lo2545/Harnet/docs/technicalTask.md

# Техническое задание

## Проект: робот-паук «Harnet» на базе ESP32

---

## 1. Общие сведения

### 1.1 Цель проекта

Целью проекта является модернизация существующего робота-паука «Аркадий».
в текущей версии реализованного на платформе Arduino с управлением через
текстовые команды по Serial-интерфейсу (репозиторий `arkadiy-core`).
Репозиторий: https://github.com/VxDxK/arkadiy-core

В рамках проекта планируется:

1. **Перенос платформы** — перевод прошивки с Arduino на ESP32 (замена
   аппаратной базы и адаптация кода: библиотека сервоприводов, распиновка,
   питание).
2. **Интерфейс ввода команд** — замена текстового ввода через Serial-порт
   на более удобный способ управления (Wi-Fi веб-интерфейс)
3. **Автономность** — добавление режима, в котором робот самостоятельно
   выполняет задачу без команд оператора (см. раздел 2.1.6).
4. **Улучшение моторики и «живое» поведение** — доработка алгоритмов
   походки для более плавных и естественных движений, а также режим,
   в котором робот имитирует поведение живого паука при выполнении
   команд (см. разделы 2.1.3 и 2.1.4).

### 1.2 Команда исполнителей
 
| Участник | Роль |
|---|---|
| Шмидько Елизавета | Исполнитель проекта (разработка аппаратной части и ПО) |
 
---

## 2. Технические требования
 
### 2.1 Требования к функциональным характеристикам
 
#### 2.1.1 Перенос платформы (Arduino → ESP32)
 
- FR-1. Управляющая прошивка должна быть перенесена с платформы Arduino на
  ESP32 с сохранением текущего набора функций управления 12 сервоприводами.
- FR-2. Итоговый набор команд управления определяется новым интерфейсом
  ввода (см. 2.1.2) и не обязан совпадать с исходным текстовым набором
  (`sp`, `su`, `ruka`, `go`, `def`) из версии на Arduino.
#### 2.1.2 Интерфейс ввода команд
 
- FR-3. Управление роботом осуществляется через веб-интерфейс: ESP32
  запускает встроенный веб-сервер, страница управления открывается в
  обычном браузере без установки отдельных
  приложений.
- FR-4. Связь между устройством оператора и роботом — по Wi-Fi. ESP32
  работает в режиме собственной точки доступа: оператор
  подключается к сети робота напрямую, наличие внешнего роутера или
  интернета не требуется.
- FR-5. Веб-страница должна содержать органы управления для всех команд
  робота: движение, смена поз, включение и отключение «живого» и автономного
  режимов (см. 2.1.3, 2.1.6), а также составление и запуск серии команд.
- FR-6. Веб-страница должна отображать текущее состояние робота (активный
  режим, текущая поза/действие, наличие связи).
- FR-7. Страница должна корректно отображаться и быть удобной для
  управления на экране смартфона.

#### 2.1.3 Режимы работы и «живое» поведение

Робот работает в следующих режимах:

- **Командный режим (по умолчанию)** — оператор подаёт одиночные команды
  или серии команд, робот выполняет их без самостоятельного поведения
  между ними.
- **«Живой» режим** — включается и выключается отдельной командой и не
  заменяет командный режим, а дополняет его: оператор по-прежнему даёт
  одиночные команды и серии команд, но робот выполняет их и ведёт себя
  в паузах как живой паук.
- **Автономный режим** — робот сам выполняет задачу без команд оператора
  (см. 2.1.6).

Свойства «живого» режима:

- FR-8. **Фоновое «дыхание»** — в состоянии покоя (в том числе между
  командами) корпус и/или ноги робота совершают едва заметные, ритмичные
  микродвижения, имитирующие дыхание живого существа.
- FR-9. **Реакция на внешние раздражители (желательная функция, не
  обязательна для приёмки)** — при обнаружении прикосновения, звука или
  приближения объекта (по данным эхолокаторов) робот выполняет одну из
  защитных реакций: резкое отдёргивание ближайшей ноги либо
  кратковременное «замирание» (полная остановка всех движений).
- FR-10. **Живое выполнение команд** — перед началом движения по команде
  робот делает короткую паузу («принюхивание») и поворачивает корпус или
  переднюю пару ног в сторону движения; при выполнении серии команд
  между отдельными командами добавляются естественные паузы; скорость и
  длительность движений имеют небольшие вариации, чтобы движения не
  выглядели механически одинаковыми.

Общие свойства движений (действуют в любом режиме):

- FR-11. **Именованные позы** — реализованы как минимум поза «отдых»
  (нейтральное, расслабленное положение) и поза «настороженность»
  (собранное положение, повышенная готовность к движению); позы
  вызываются командами. В «живом» режиме робот сам принимает позу
  «отдых» в покое и позу «настороженность» при реакции на раздражитель.
- FR-12. **Плавность переходов** — переход сервоприводов между двумя
  позами выполняется не мгновенно, а с разгоном и торможением
  (плавное нарастание и спад скорости), без резких скачков угла.
- FR-13. **«Волновая» походка** — при перемещении ноги переставляются не
  синхронно, а с последовательным сдвигом по фазе между ногами
  («бегущая волна»).

Переключение режимов:

- FR-14. «Живой» режим включается одной командой и выключается другой,
  независимо от командного режима: оператор может подавать команды как при
  включённом, так и при выключенном «живом» режиме. В обоих случаях
  доступны одиночные команды и серии команд (последовательность команд,
  выполняемая подряд). Команды подаются через интерфейс ввода
  (см. 2.1.2).
 
#### 2.1.4 Улучшение моторики
 
- FR-15. **Направления движения.** Робот должен уметь ходить вперёд и
  назад, а также поворачиваться на месте влево и вправо.
- FR-16. **Скорость.** Должно быть доступно не менее двух режимов скорости
  движения: медленный («крадущийся») и быстрый. Режим выбирается из
  веб-интерфейса; смена скорости происходит плавно, без рывков.
- FR-17. **Положение корпуса.** Робот должен уметь наклонять корпус
  (вперёд/назад), приседать и приподниматься, а также поднимать
  передние ноги.
- FR-18. **Устойчивость.** Во время ходьбы и смены поз робот не должен
  терять равновесие и заваливаться: в каждый момент движения не менее
  двух ног опираются на поверхность.
- FR-19. **Плавный старт и остановка.** Начало и окончание движения
  выполняются без рывков, с постепенным набором и сбросом скорости
  (см. FR-12).

#### 2.1.5 Обнаружение препятствий
 
- FR-20. Робот оснащается эхолокаторами (см. 2.4) и измеряет расстояние до
  объектов перед собой.
- FR-21. В режиме автономного поведения при обнаружении препятствия ближе
  заданного порога робот останавливается, поворачивается в
  сторону, где свободнее, и продолжает движение.
- FR-22. Текущие показания эхолокаторов отображаются в веб-интерфейсе.
- В командном режиме робот выполняет команды оператора, показания
  датчиков только отображаются.

#### 2.1.6 Автономный режим

- FR-23. Автономный режим включается и выключается отдельной командой, в
  которой оператор выбирает задачу (см. FR-25). В нём робот самостоятельно,
  без команд оператора, выполняет выбранную задачу, принимая решения по
  данным датчиков.
- FR-24. Решения принимает алгоритм управления, работающий на самом ESP32
- FR-25. В автономном режиме доступны следующие задачи:
  - **«Исследование»** — робот идёт вперёд и обходит препятствия
    (см. FR-21).
  - **«Дойти и замереть»** — робот идёт вперёд, пока расстояние до
    препятствия не станет меньше порога, затем останавливается и замирает
    в позе «настороженность» до команды оператора или до исчезновения
    препятствия.
  - **«Патрулирование по кругу»** — робот движется по замкнутой
    круговой траектории (непрерывная ходьба с постоянным поворотом),
    при появлении препятствия обходит его и возвращается к патрулированию.
    Точная траектория не гарантируется.
- FR-26. Оператор может в любой момент прервать автономный режим командой
  остановки, после чего робот возвращается в командный режим.
- FR-27. Автономный режим может использоваться вместе с «живым»: тогда
  самостоятельные движения выполняются в «живой» манере.
  
### 2.2 Требования к надежности
 
- NFR-1. **Автономное питание.** Робот питается от батареек,
  внешнее питание проводом в рабочем режиме не
  требуется. Время непрерывной работы от одного комплекта — не менее
  10 минут активного использования.
- NFR-2. **Стабильность электроники.** Просадки напряжения при работе
  сервоприводов не должны приводить к перезагрузке ESP32 или разрыву
  Wi-Fi соединения; питание сервоприводов и управляющей платы организуется
  так, чтобы нагрузка двигателей не влияла на микроконтроллер.
- NFR-3. **Поведение при потере связи.** При пропадании Wi-Fi соединения
  с оператором в командном режиме робот останавливается и принимает позу
  «отдых». В режиме автономного поведения потеря связи не прерывает
  работу робота: вся логика выполняется на самом ESP32.
- NFR-4. **Время отклика.** Задержка между нажатием кнопки в
  веб-интерфейсе и началом выполнения команды роботом — не более 0,5 с.
- NFR-5. **Низкий заряд батареи.** При падении
  напряжения питания ниже допустимого робот принимает позу «отдых» и
  сообщает об этом в веб-интерфейсе.
### 2.3 Условия эксплуатации
 
- Эксплуатация только в помещении, на ровной твёрдой поверхности (пол,
  стол).
- Температура окружающей среды от +10 до +35 °C, отсутствие влаги и
  сильной запылённости.
- Расстояние от оператора до робота — до 10 м в пределах прямой видимости.
- Работа оператора с роботом — со смартфона или компьютера со
  стандартным современным браузером.
### 2.4 Требования к составу и параметрам технических средств
 
| № | Компонент | Требования / параметры | Статус |
|---|---|---|---|
| 1 | Управляющая плата | ESP32 (отладочная плата на базе ESP32-WROOM-32 с USB), не менее 12 свободных GPIO с поддержкой ШИМ, встроенный Wi-Fi 2,4 ГГц. Заменяет Arduino Nano (ATmega328P: 16 МГц, 2 КБ ОЗУ, 32 КБ flash) | есть в наличии |
| 2 | Сервоприводы | 12 шт. (по 3 на каждую из 4 ног), управление ШИМ 50 Гц, питание 4,8–6 В; модель уточняется | есть в наличии |
| 3 | Корпус и ноги | 3D-печатная конструкция существующего робота, без изменения | есть в наличии |
| 4 | Источник питания | Батарейный блок на 4,8–6 В для линии сервоприводов, способный отдавать пиковый ток не менее 1 А *(значение предложено, уточняется после определения модели серв)*. Рекомендуются перезаряжаемые никель-металлгидридные элементы типоразмера AA с зарядным устройством: у обычных щелочных батареек высокое внутреннее сопротивление, под нагрузкой 12 серв напряжение проседает | закупка |
| 5 | Эхолокаторы (ультразвуковые датчики расстояния) | 2 шт. спереди, под углом друг к другу *(количество предложено)*; диапазон измерения не менее 10–100 см. Сигнал датчиков типа HC-SR04 имеет уровень 5 В, а входы ESP32 рассчитаны на 3,3 В, поэтому требуется согласование уровней (делитель напряжения) либо датчики с логикой 3,3 В | закупка |
| 6 | Датчики касания и звука | Для функции FR-9 | опционально |
| 7 | Монтаж | Провода, разъёмы, плата или клеммник для разводки питания на 12 серв, конденсатор на линии питания серв, резисторы для согласования уровней датчиков | закупка |

### 2.5 Требования к информационной и программной совместимости
 
- Прошивка пишется на C++ с использованием Arduino-фреймворка для ESP32;
  допустимые среды сборки — Arduino IDE.
- Для управления сервоприводами используется библиотека ESP32Servo.
- Сохраняется трёхуровневая архитектура исходного проекта: ArkadiyCore
  (перемещения и управление конечностями) → ServoWrapper (ограничения
  углов каждого сустава) → библиотека сервоприводов. Перенос на ESP32
  должен затрагивать в первую очередь нижний уровень, логика ограничений и
  движений сохраняется.
- Веб-интерфейс написан на HTML/CSS/JavaScript, хранится в памяти ESP32 и
  не использует внешние ресурсы из интернета (точка доступа робота
  интернета не предоставляет).
- Интерфейс работает в актуальных версиях Chrome, Safari и Firefox на
  смартфоне и компьютере.
- Обмен между браузером и роботом — по протоколу HTTP (допускается
  WebSocket для потока команд и статуса).
- Исходный код хранится в Git-репозитории проекта.
  
### 2.6 Требования к транспортированию и хранению
 
- Транспортировка робота осуществляется в выключенном состоянии, в жёсткой
  коробке или контейнере, с фиксацией ног в сложенном положении, чтобы
  исключить удары и изгиб 3D-печатных деталей.
- Перед транспортировкой и хранением из робота извлекаются элементы
  питания.
- Не допускается принудительно двигать ноги руками при включённом питании
  и при подключённых сервоприводах: это может повредить шестерни серв.
- Хранение — в сухом помещении при температуре от +5 до +35 °C, вдали от
  источников тепла и прямых солнечных лучей.
- При длительном хранении (более месяца) перезаряжаемые элементы питания
  хранятся отдельно.
---
 
## 3. Требования к документации
 
Проектная документация хранится в Git-репозитории проекта вместе с исходным
кодом.
 
### 3.1 Схемы
 
- Электрическая принципиальная схема подключения: ESP32, 12 сервоприводов,
  эхолокаторы, батарейный блок, цепи согласования уровней и питания.
- Таблица распиновки: соответствие каждого сервопривода (нога, сустав) и
  каждого датчика номеру GPIO платы ESP32.
### 3.2 Описание программного обеспечения
 
- Структура прошивки по слоям: ArkadiyCore, ServoWrapper, библиотека
  сервоприводов (ESP32Servo), модуль веб-интерфейса.
- Перечень команд и режимов работы (командный, «живой» и автономный
  режимы), параметры, которые можно настраивать (пороги датчиков,
  скорости).
- Описание веб-интерфейса: назначение элементов управления, протокол
  обмена с роботом.
- Инструкция по сборке и загрузке прошивки на ESP32 (файл `README.md`).
### 3.3 Руководство пользователя
 
- Включение робота и замена элементов питания.
- Подключение к Wi-Fi сети робота и открытие страницы управления.
- Описание кнопок и режимов веб-интерфейса.
- Правила безопасного обращения, транспортировки и хранения (см. 2.6).
- Типичные неисправности и способы их устранения.
---
 
## 4. Технико-экономические показатели
 
### 4.1 Источник финансирования
 
Проект реализуется за счёт средств университета. Закупка выполняется на
основании сметы, представленной ниже.
 
### 4.2 Предварительная смета закупок
 
Цены ориентировочные, подлежат уточнению по актуальным предложениям
магазинов на момент закупки.
 
| № | Позиция | Кол-во | Цена, ₽ | Сумма, ₽ |
|---|---|---|---|---|
| 1 | Ультразвуковые датчики расстояния HC-SR04 | 2 | 150 | 300 |
| 2 | Аккумуляторы Ni-MH типоразмера AA | 4 | 200 | 800 |
| 3 | Зарядное устройство для Ni-MH AA | 1 | 1000 | 1000 |
| 4 | Держатель для 4 элементов AA | 1 | 100 | 100 |
| 5 | Выключатель питания | 1 | 100 | 100 |
| 6 | Набор соединительных проводов (Dupont) | 1 | 300 | 300 |
| 7 | Набор резисторов (делитель напряжения для датчиков) | 1 | 150 | 150 |
| 8 | Электролитические конденсаторы 1000 мкФ | 2 | 50 | 100 |
| 9 | Клеммник / плата разводки питания | 1 | 300 | 300 |
| | **Итого к закупке** | | | **3150** |
 
Уже имеются и в закупку не входят: плата ESP32, 12 сервоприводов,
3D-печатный корпус.
 
---
 
## 5. Стадии и этапы разработки
 
Срок завершения работ — 15.12.2026. 
 
| Этап | Сроки | Содержание работ | Документы и результаты |
|---|---|---|---|
| 1. Подготовка | 07.10–19.10 | Утверждение ТЗ и сметы, заказ комплектующих, установка Arduino IDE и поддержки ESP32 | ТЗ, смета |
| 2. Перенос на ESP32 | 20.10–02.11 | Выбор GPIO, замена библиотеки Servo на ESP32Servo, проверка каждого сервопривода отдельно, запуск прежних команд и ограничений углов (ServoWrapper) на ESP32 | Таблица распиновки, черновик схемы подключения |
| 3. Питание и веб-интерфейс | 03.11–16.11 | Монтаж питания от батареек (после получения деталей), Wi-Fi точка доступа и веб-страница управления, отображение статуса, подключение и чтение эхолокаторов | Электрическая схема, описание веб-интерфейса |
| 4. Улучшение моторики | 17.11–30.11 | Плавные переходы, волновая походка, движения вперёд/назад и повороты, две скорости, позы, наклон и приседание корпуса | Описание ПО (слои, команды, параметры) |
| 5. «Живое» поведение и автономность | 01.12–07.12 | «Живой» режим (включение/выключение, дыхание, живое выполнение команд и серий команд), автономный режим (задачи «исследование», «дойти и замереть», «патрулирование по кругу», обход препятствий), реакция на приближение объекта, поведение при потере связи | Обновлённое описание режимов |
| 6. Испытания и документация | 08.12–14.12 | Проверка по требованиям ТЗ, исправление ошибок, руководство пользователя, README, подготовка демонстрации | Руководство пользователя, README, протокол проверки |
| Защита | 15.12 | Демонстрация проекта (см. раздел 6) | |

---
 
## 6. Порядок контроля и приемки
 
### 6.1 Виды испытаний
 
Проверка выполняется исполнителем по таблице соответствия требований ТЗ
способам проверки; результаты фиксируются в протоколе испытаний.
 
| Требования | Способ проверки |
|---|---|
| FR-1, FR-2 (перенос на ESP32) | Запуск прошивки на ESP32, проверка движения каждого из 12 серв и соблюдения ограничений углов |
| FR-3…FR-7 (веб-интерфейс) | Подключение смартфона к Wi-Fi робота, открытие страницы, выполнение всех команд, проверка отображения статуса на экране смартфона |
| FR-8, FR-10, FR-14 («живой» режим) | Включение «живого» режима, наблюдение дыхания в покое, пауз-«принюхивания» и поворота корпуса перед выполнением одиночных команд и серии команд; отключение режима и проверка, что команды выполняются без этих особенностей |
| FR-11…FR-13, FR-19 (позы, плавность, волновая походка) | Вызов поз «отдых» и «настороженность», визуальный осмотр движения, видеозапись, проверка отсутствия рывков при старте и остановке |
| FR-15…FR-18 (моторика) | Ходьба вперёд, назад, повороты, обе скорости, наклон и приседание; проверка, что робот не заваливается |
| FR-20…FR-22 (эхолокаторы) | Установка препятствия на пути робота, проверка остановки, обхода и отображения расстояния |
| FR-23…FR-27 (автономный режим) | Включение автономного режима, выбор и наблюдение выполнения каждой из задач («исследование», «дойти и замереть», «патрулирование по кругу») без команд оператора, прерывание режима командой остановки |
| NFR-1, NFR-2 (питание) | Непрерывная работа от одного комплекта элементов не менее 10 минут, контроль отсутствия перезагрузок ESP32 |
| NFR-3 (потеря связи) | Отключение Wi-Fi устройства оператора в командном и в автономном режиме |
| NFR-4 (время отклика) | Измерение задержки между нажатием кнопки и началом движения |
| Раздел 3 (документация) | Проверка наличия схем, описания ПО и руководства пользователя в репозитории |
 
### 6.2 Демонстрация на защите
 
1. Включение робота от батареек, подключение смартфона к Wi-Fi сети
   робота, открытие страницы управления.
2. Базовые движения по командам: вперёд, назад, повороты, две скорости,
   позы «отдых» и «настороженность», наклон и приседание корпуса.
3. Показ плавности переходов и «волновой» походки.
4. Включение «живого» режима: дыхание в покое, выполнение одиночной
   команды и серии команд в «живой» манере; затем выключение режима и
   показ тех же команд без «живых» особенностей.
5. Автономный режим: выбор задачи «исследование» (паук идёт сам и
   обходит предмет на пути), затем «дойти и замереть» и «патрулирование
   по кругу»; остановка командой.
6. Поведение при потере связи в режимах с управлением оператором и в
   автономном режиме.
7. Показ документации: репозиторий проекта, схемы, описание ПО,
   руководство пользователя.
### 6.3 Общие требования к приемке
 
- Работа принимается, если выполнены все требования ТЗ, кроме помеченных
  как желательные или необязательные (FR-9, NFR-5, датчики касания и
  звука).
- Все этапы раздела 5 завершены, документы раздела 3 размещены в
  репозитории проекта.
- Робот демонстрируется в рабочем состоянии на ровной поверхности в
  помещении в условиях, указанных в разделе 2.3.
- Затраты соответствуют смете из раздела 4.
---
 
## 7. Ссылки на источники
 
1. ГОСТ 19.201-78 Техническое задание. Требования к содержанию и оформлению
2. Презентация исходного проекта «Роботизированная платформа "Павук Аркадий"» (файл piikt-pauk.pdf)
3. Репозиторий исходного проекта: https://github.com/VxDxK/arkadiy-core
