lo2545/Harnet/docs/perfboard_layout.png

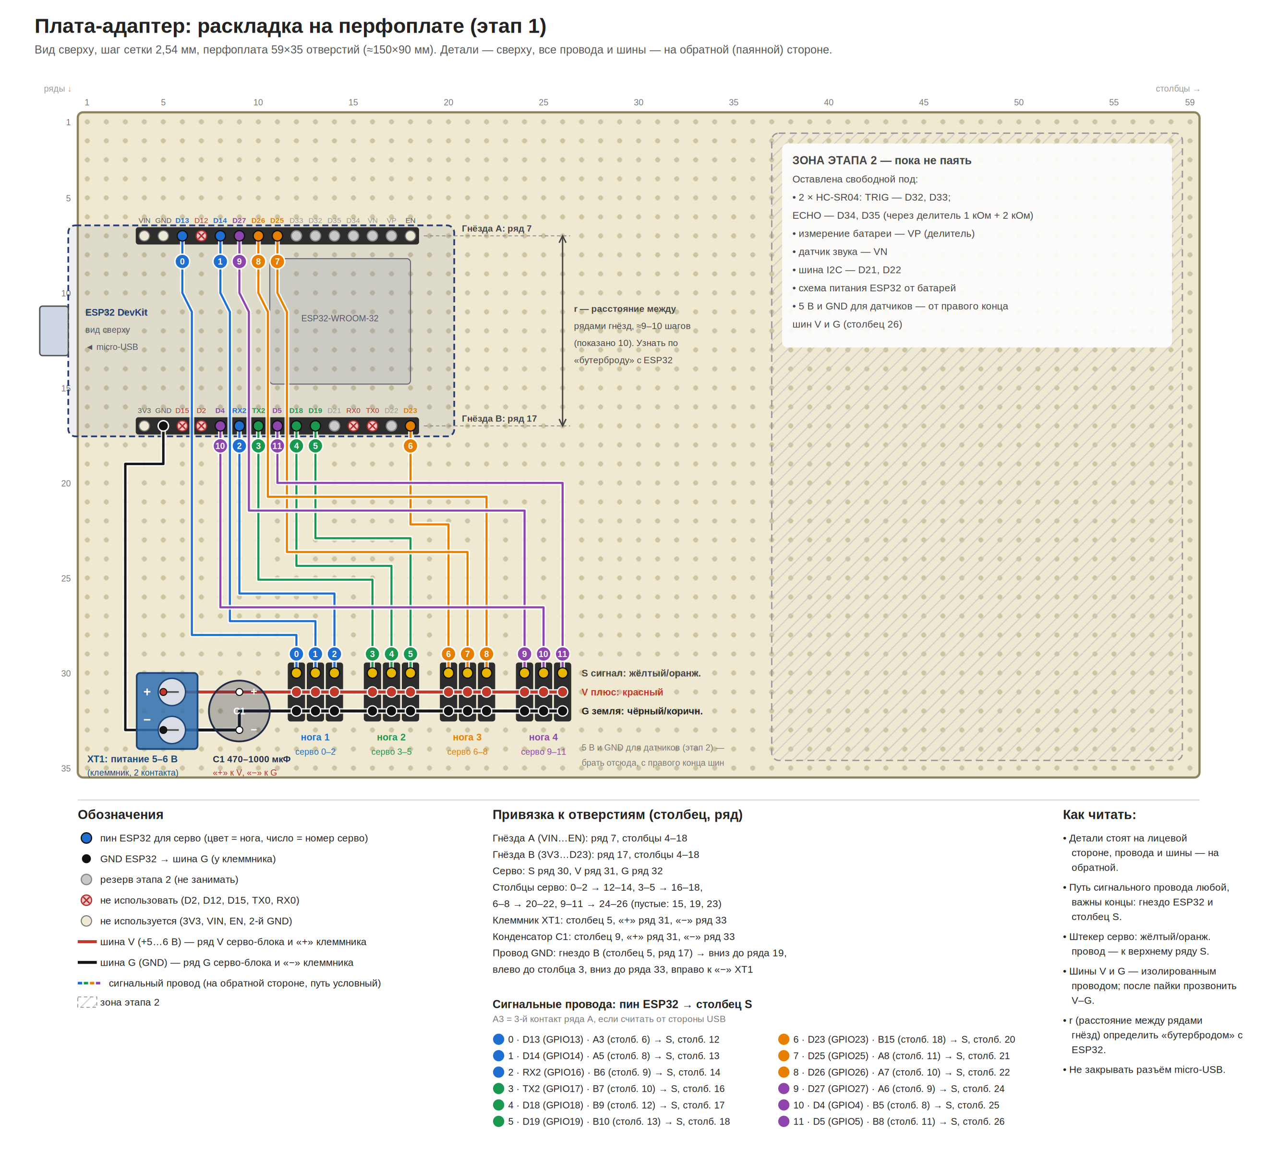
docs/perfboard_layout.png
