lo2545/Harnet/docs/schema_electrical.png

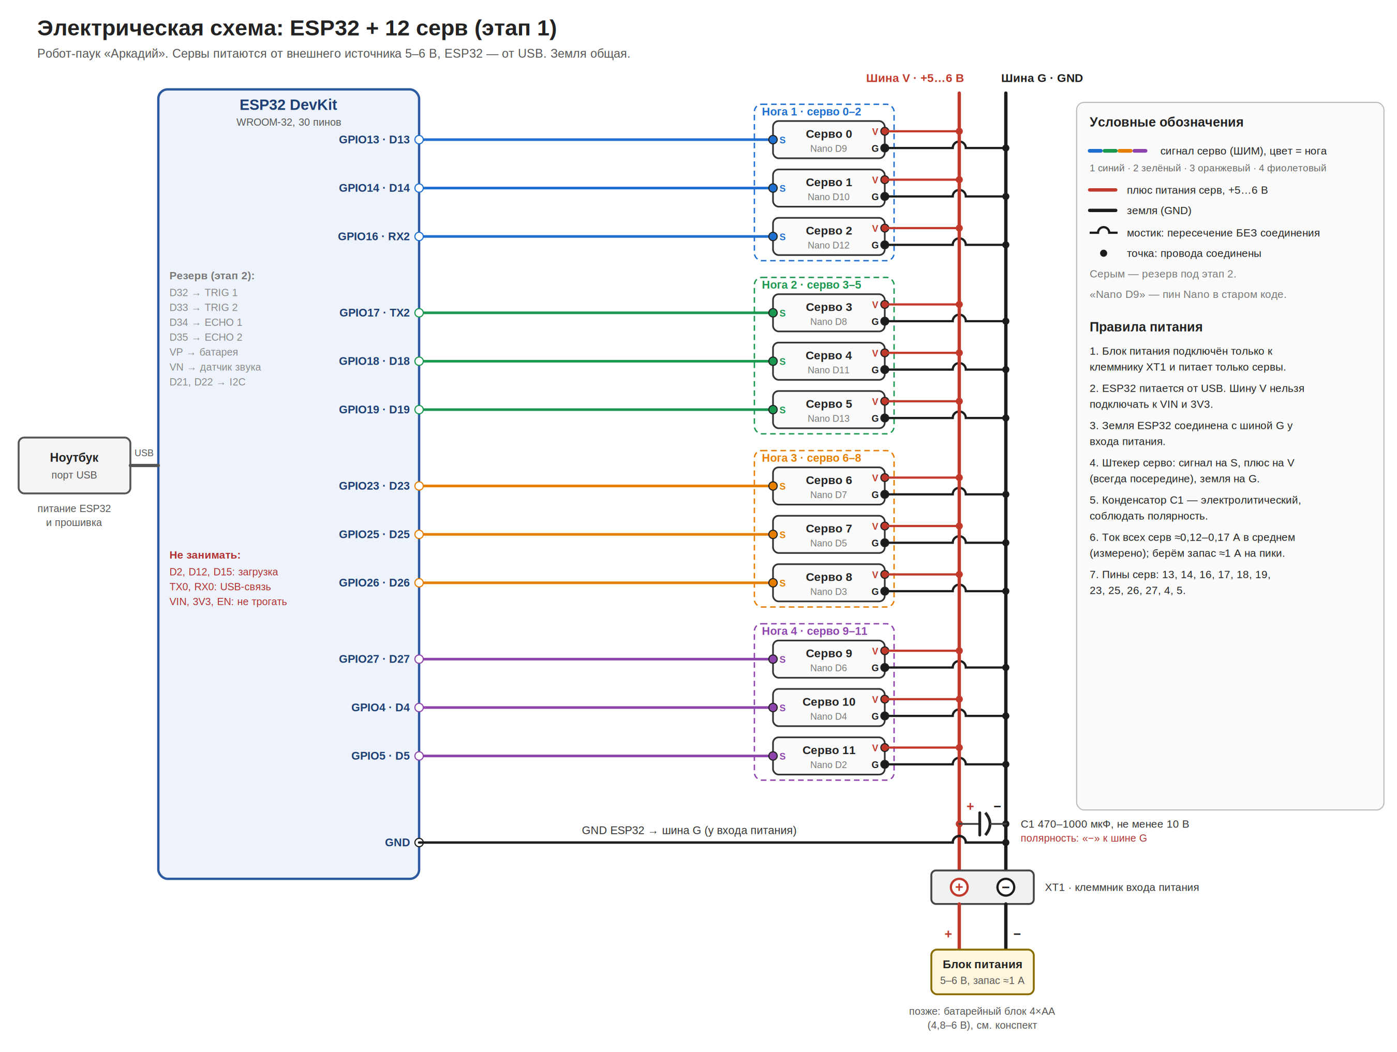
docs/schema_electrical.png
